Richard-V31/17_Autorisation_Ouverture_et_memorisation_avec_HD44780/Controle_Acces_RFID_RC522_HD44780.jpg

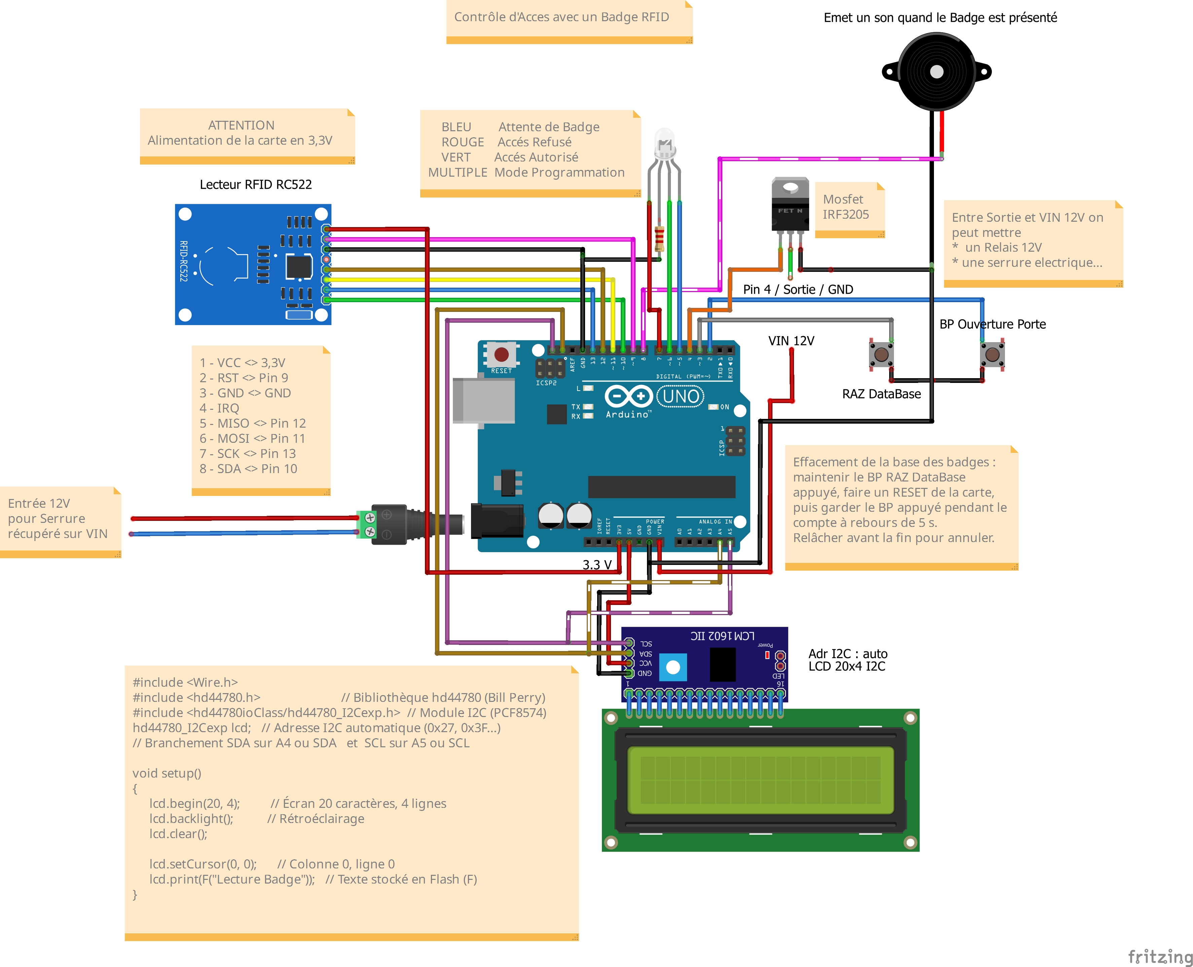
Controle_Acces_RFID_RC522_HD44780.jpg
