Richard-V31/17_Autorisation_Ouverture_et_memorisation_avec_HD44780/(list of files, drawings)

Other design files:
Controle_Acces_RFID_RC522_HD44780.fzz
